mjm41/rc-boat/README.md

# RC Toy Boat Conversion (ESP8266 + L298N + Servo Rudder)

This project turned a plastic bathtube toy into a WiFi-controlled RC boat using:
- **ESP8266** (boat firmware)
- **L298N** dual H-bridge (2x DC motors)
- **Servo** for rudder steering
- A handheld controller built from an **Arduino UNO R4 WiFi + Modulino joystick**

This README is a build log with photos, wiring, and lessons learned (including how we stopped snapping the rudder off).

---

## Demo Video

🎥 **Video:**
[RC Boat Demo](https://youtube.com/shorts/XjPl-BF36Mk)

---

## Build Log (Photos + Steps)

### 1) Cut out top + add splash cover
Cut out the middle of the toy boat top and **super-glue** a plastic cover in place for splash protection.

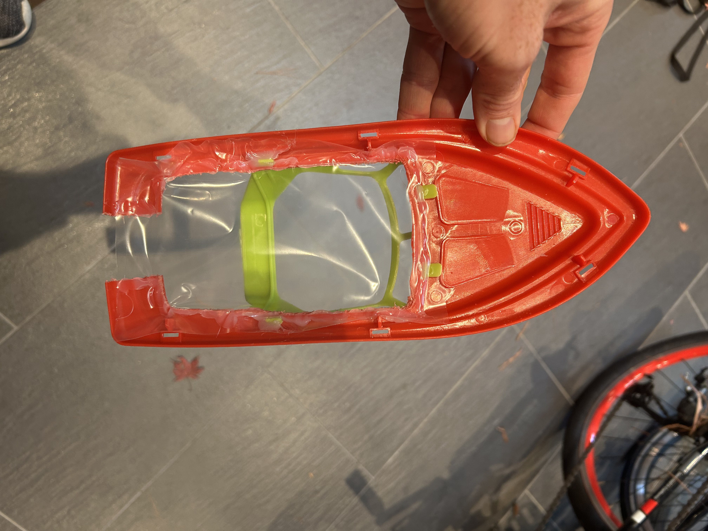
[picture p1: docs/01-Toy-Boat-Top.jpg]
Step 1 - toyboat top


### 2) Attach rudder (epoxy centered on stern)
Rudder mount is centered on the stern using plastic epoxy.

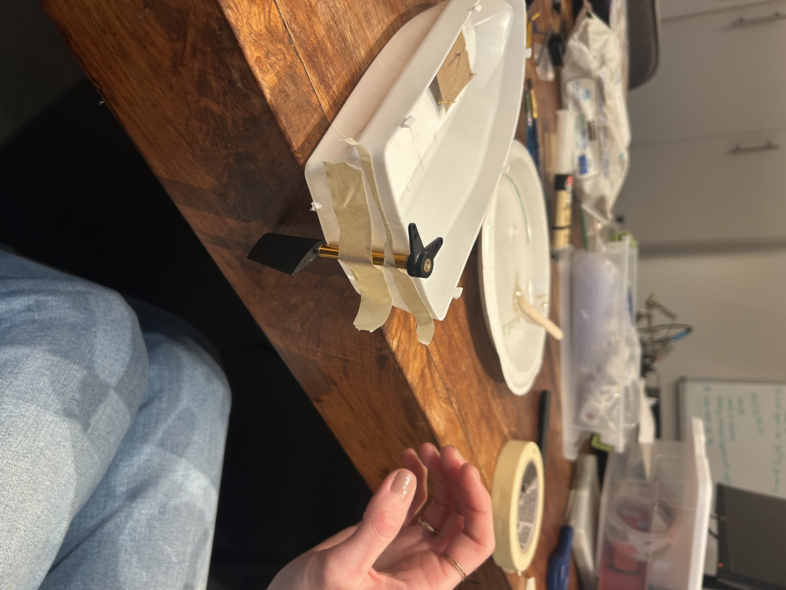
[picture p2: docs/02-rudder-attached.jpg]
Step 2 - rudder attached


### 3) Epoxy four posts for the L298N mount
Set **4 posts in epoxy** to hold the L298N motor driver above the hull.

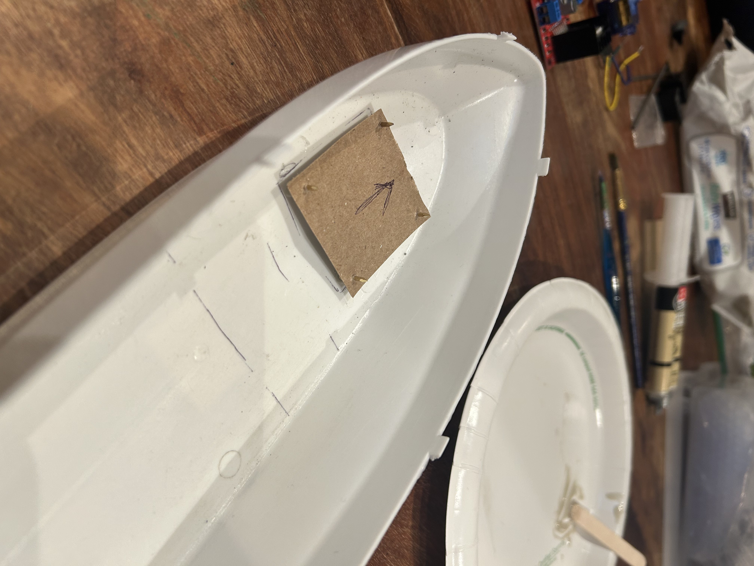
[picture p3: docs/03-posts-l298n.jpg]
Step 3 - posts for L298N


### 4) Epoxy motors + servo
Epoxy:
- **2x DC motors** (propulsion)
- **1x servo** (rudder control)

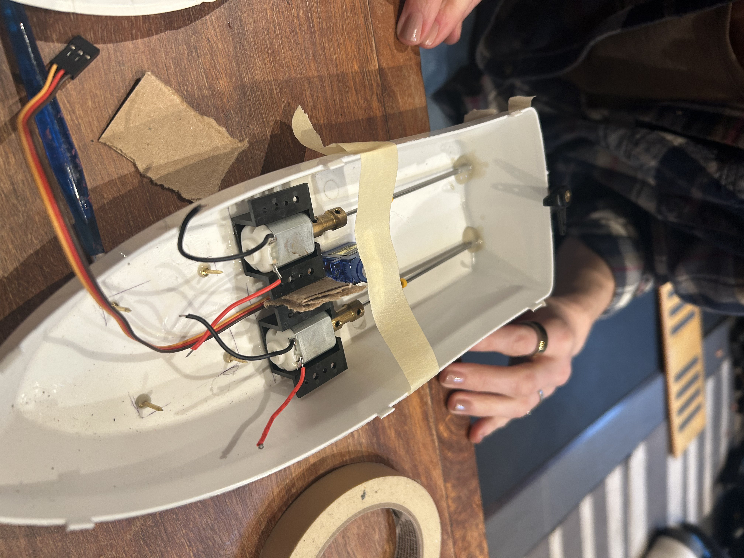
[picture p4: docs/04-motors-and-servo.jpg]
Step 4 - motors and servo


### 5) L298N motor outputs wiring
Motor wiring on the L298N output terminals:

- **Motor 1**: `+ -> OUT2`, `- -> OUT1`
- **Motor 2**: `+ -> OUT4`, `- -> OUT3`

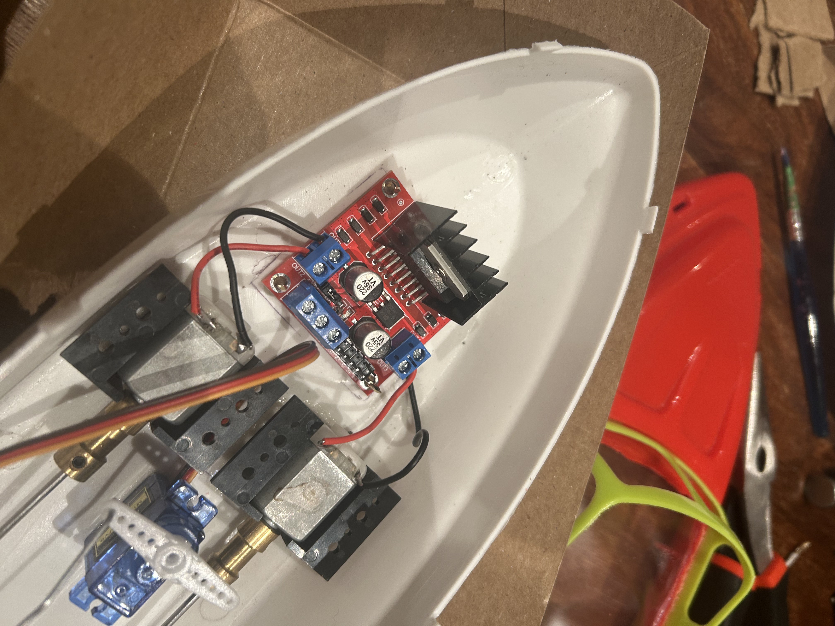
[picture p5: docs/05-l298n-outs.jpg]
Step 5 - L298N motor wiring


### 6) Build a boat holder (rudder broke twice)
We snapped the rudder off twice, so we built a holder/stand to keep the boat stable during work + testing.

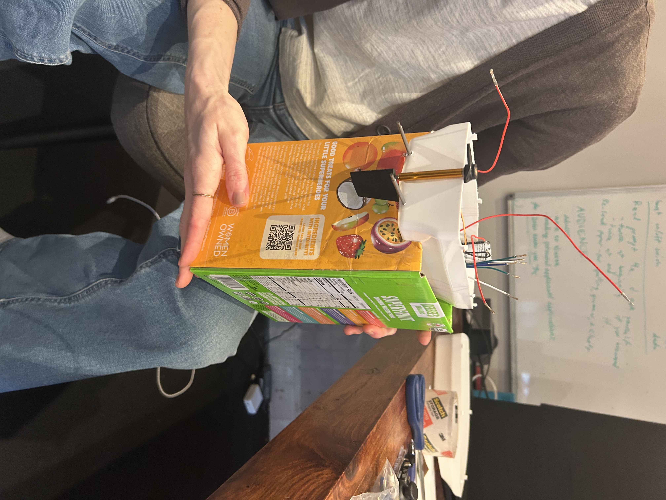
[picture p6: docs/06-boat-holder.jpg]
Step 6 - boat holder


### 7) Connect L298N EN/IN + servo signal to ESP8266 (pin map)
Pin mapping (ESP8266 GPIO):

```cpp
motor1Pin1  = GPIO12;
motor1Pin2  = GPIO14;
enable1Pin  = GPIO13;

motor2Pin1  = GPIO4;
motor2Pin2  = GPIO5;
enable2Pin  = GPIO15;

servoPin    = GPIO0;
```

### Power + grounds

- **Servo VIN** → ESP8266 **3V3** and **GND**
- **6V (4x AAA)** battery pack → **VIN** on ESP8266
- **All grounds** tied together to a **common central point**

Step 7 - connect ESP pins


---

### 8) Two power switches

- **Switch #1:** controls power to the **L298N**
- **Switch #2:** controls power to the **ESP8266** (also powers the **servo**)

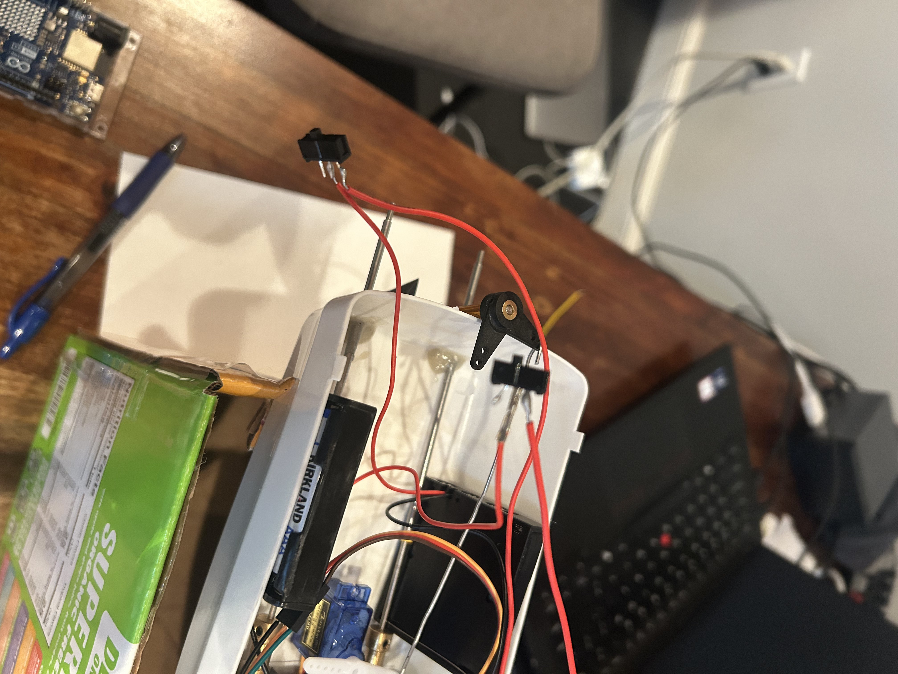
[picture p8: docs/08-power-switches.jpg]
Step 8 - power switches


---

### 9) Paper-clip linkage from servo horn to rudder

Stretch out a paper clip to connect the servo horn to the rudder.  
Loop it around the connectors so it won’t pop off easily.

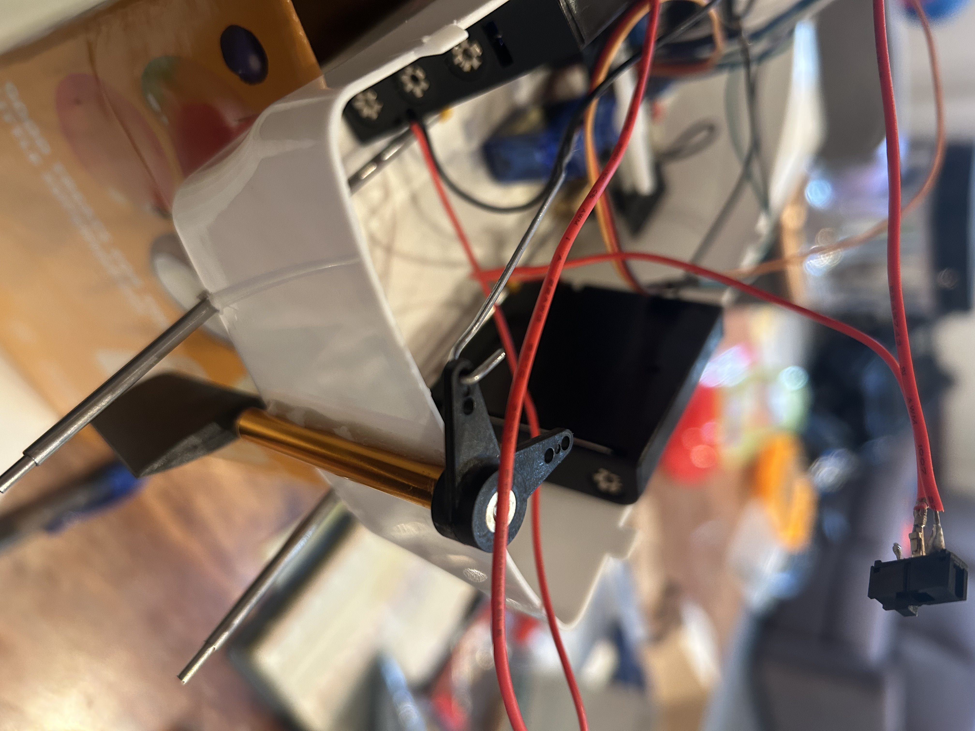
[picture p9: docs/09-servo-rudder.jpg]
Step 9 - connect servo to rudder


---

### 10) Install propeller screws onto motor shafts

Insert the propeller screws onto the motor/propeller shafts.

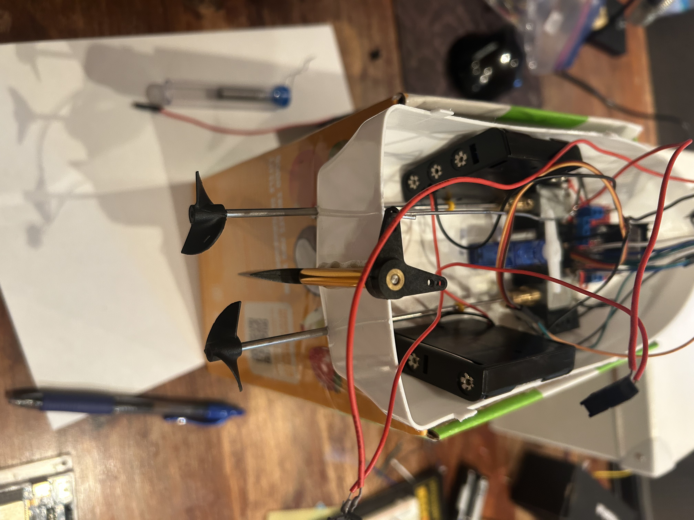
[picture p10: docs/10-propeller-screws.jpg]
Step 10 - install propeller screws


---

### 11) Check trim in a sink

Check the boat trim in a bathroom sink:

- Ensure it sits level
- Not too heavy at stern or bow
- Rudder centered

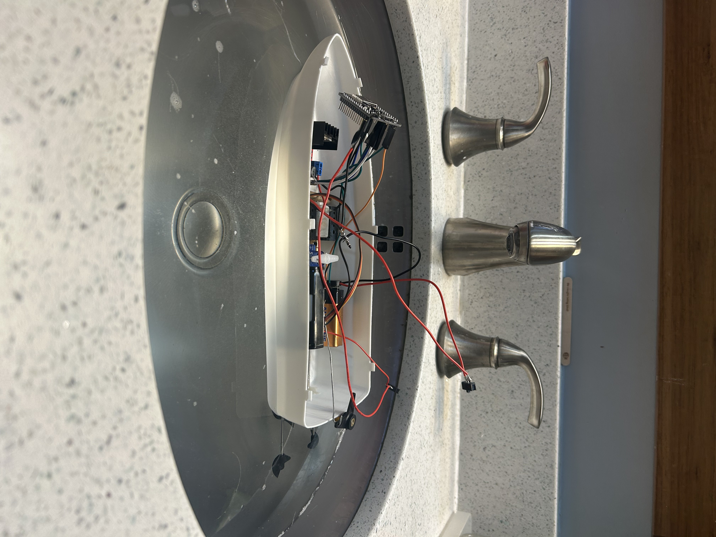
[picture p11: docs/11-trim-test.jpg]
Step 11 - trim test


---

### 12) Extra water protection (plastic wrap + electrical tape)

Cover the hull with plastic wrap and use electrical tape to hold it down as an extra splash barrier.

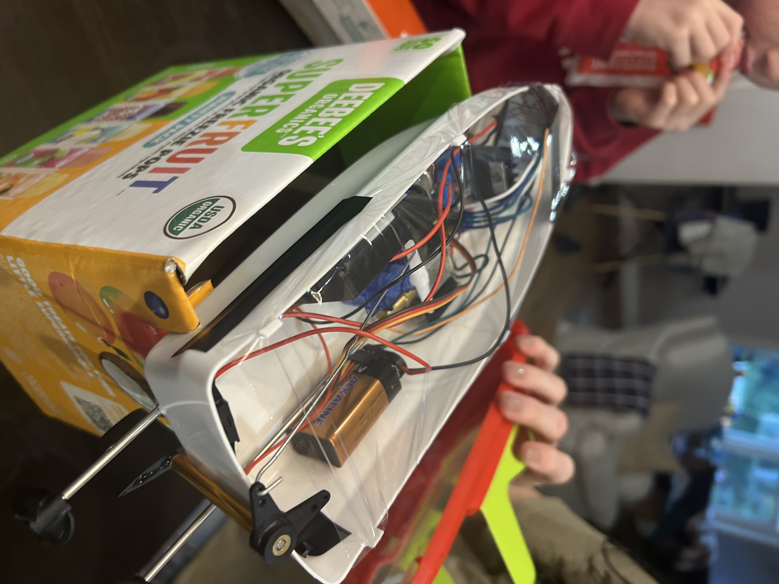
[picture p12: docs/12-extra-protection.jpg]
Step 12 - extra protection

---

### 13) Reattach the toy boat top

Reconnect the boat top to complete the assembly.

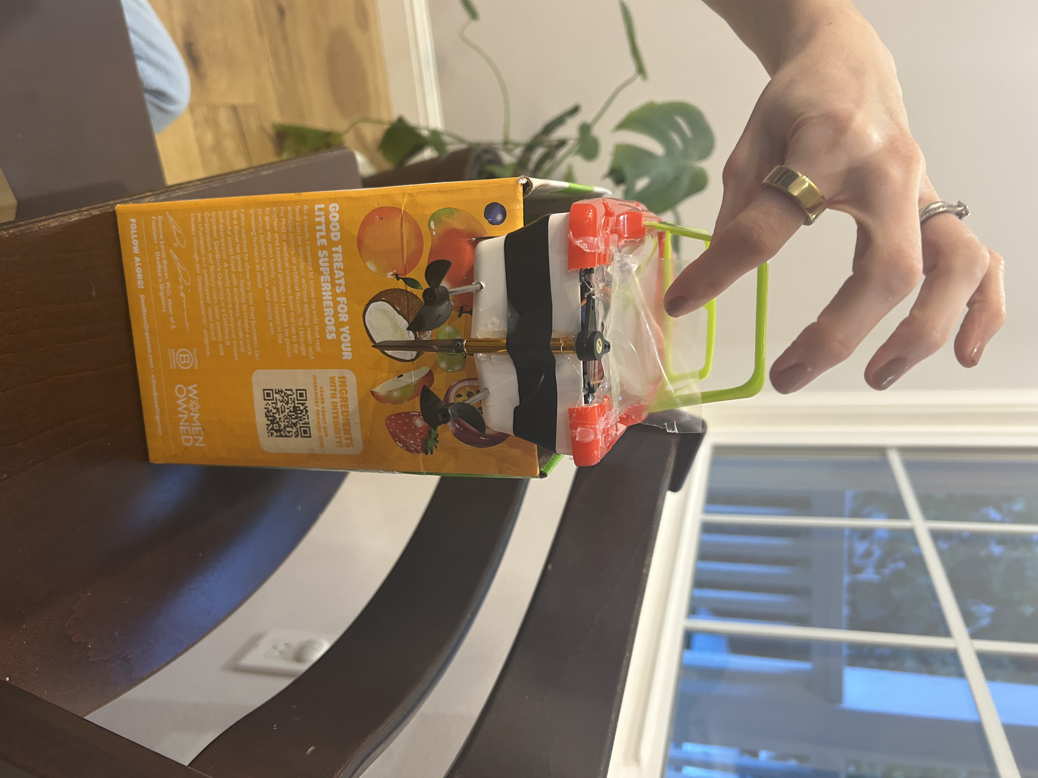
[picture p13: docs/13-reattach-top.jpg]
Step 13 - reattach top


---

### 14) Build the controller (UNO R4 WiFi + Modulino joystick)

Controller build:

- Arduino UNO R4 WiFi
- Modulino joystick
- On/off switch
- 9V battery on the back, secured with electrical tape

Step 14 - build controller

---

## Wiring Summary

### L298N ↔ Motors

| Motor | L298N Terminal | Polarity |
|---:|---|---|
| 1 | OUT2 / OUT1 | + / - |
| 2 | OUT4 / OUT3 | + / - |

### ESP8266 ↔ L298N + Servo

| Function | ESP8266 GPIO |
|---|---|
| Motor1 IN1 | GPIO12 |
| Motor1 IN2 | GPIO14 |
| Motor1 EN | GPIO13 |
| Motor2 IN1 | GPIO4 |
| Motor2 IN2 | GPIO5 |
| Motor2 EN | GPIO15 |
| Servo signal | GPIO0 |

---

## Parts List

### Boat
- Toy RC boat hull + top
- Plastic wrap (splash shield)
- Plastic epoxy / epoxy putty
- Super glue
- Electrical tape
- Paper clip (rudder linkage)

### Electronics (boat)
- ESP8266 dev board (NodeMCU-style)
- L298N motor driver
- 2x small DC motors + props + screws
- 1x servo motor
- 2x on/off switches
- 4x AAA battery pack (6V) for ESP8266 VIN and servo (and shared grounds)
- 9V for motor driver

### Controller
- Arduino UNO R4 WiFi
- Modulino joystick
- On/off switch
- 9V battery

---

## Notes / Lessons Learned
- The rudder is fragile—use a holder/stand while working and testing.
- First attempt: servo worked but DC motors did not. I was using 4x AAA for DC motors. When I upgraded to 9V, the motors worked without issue. 
- Second attempt: boat spun uncontrollably. propellers must spin in opposite direction to move in a straight line. Fixed via software upgrade.
- Third attempt: power was on for all electronics but no signals were being tx/rx from controller to boat. Upgraded controller to 9V and it worked fine after that. 
- Still an issue: left screw often doesn't spin. Actively troubleshooting. 
- There is a constant humming which I take to be due to not turning pins to LOW when not using. Actively troubleshooting.
- The design decision to use 1x joystick was not smart. You can't do fast turns because when you move joystick all the way to side, it completely slows down (y-axis moves towards center). I'm considering using the button in the joystick and writing code that uses that as a speed autopilot so I can maintain a faster speed while moving rudder. 

---

## License
This project is licensed under the **MIT License**. See [`LICENSE`](LICENSE) for details.
