mjm41/rc-boat/docs/07-esp-pins.jpg

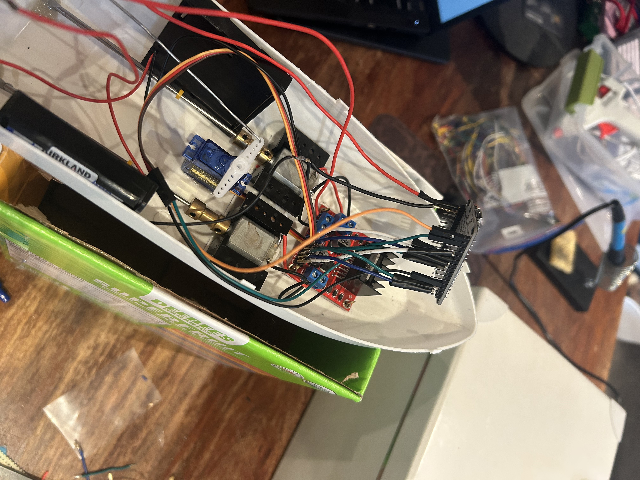
[picture p7: docs/07-esp-pins.jpg]
docs/07-esp-pins.jpg
