mjm41/rc-boat/docs/14-build-controller.jpg

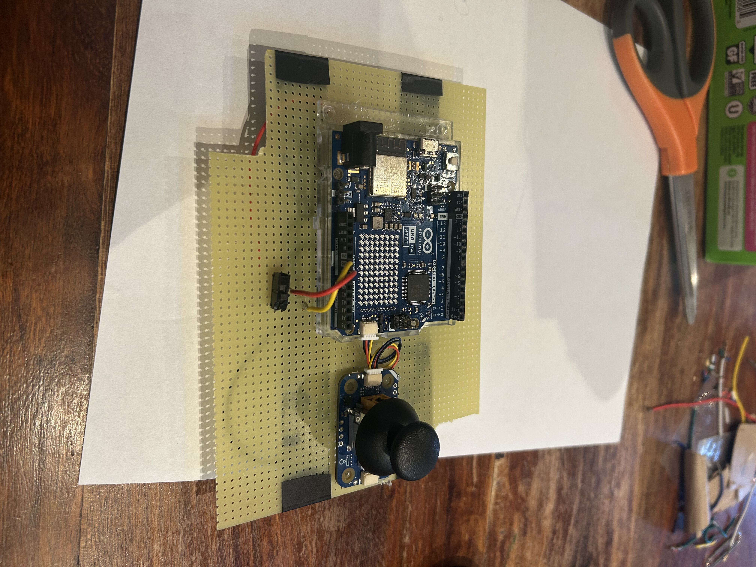
[picture p14: docs/14-build-controller.jpg]
docs/14-build-controller.jpg
